nickdpz/Control-de-Inversor/README.md

# Control-de-Inversor
A partir de una fuente DC se obtiene una señal ac proporcional al voltaje DC. Se utiliza modulacion bipolar para obtener la señal a.c despues de pasar por un filtro rlc que filtre las frecuencias superiores a 60Hz. Se utiliza la topoligia de Mosfet de potencia en puente, los disparos de los mosfet se realizan con un circuito integrado que incorpora el efecto bootstrap.
