nickdpz/Control-de-Inversor/Esquematico.PDF

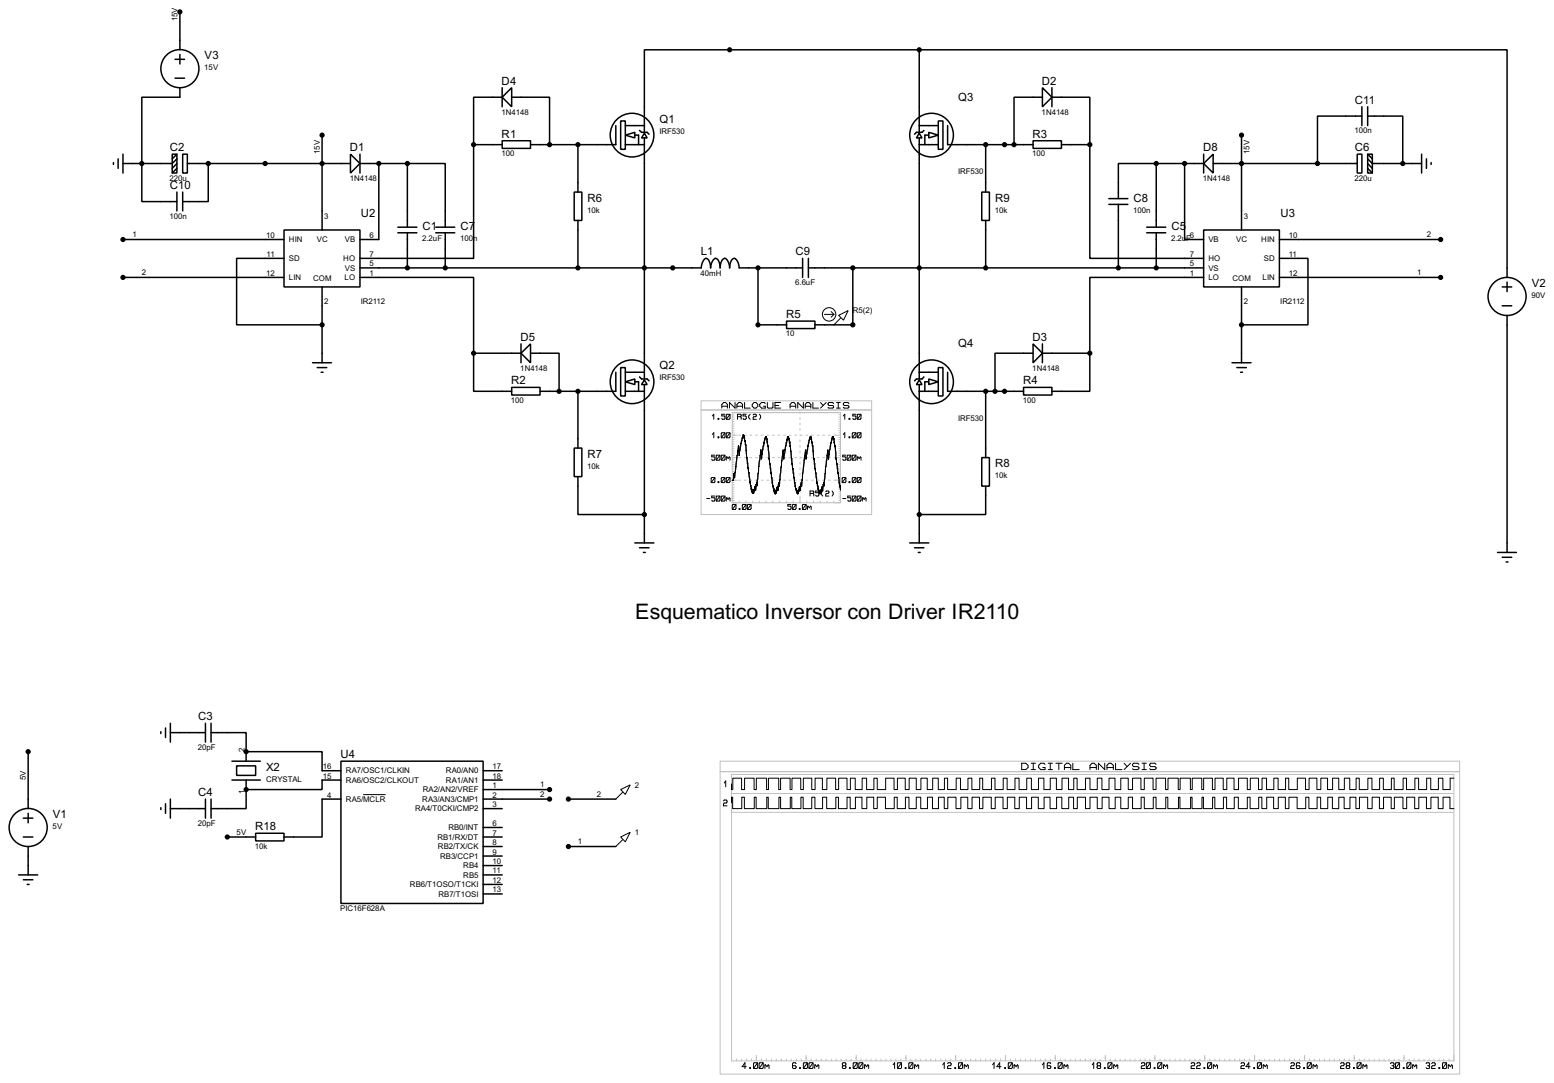
[picture p7: page 1]

Esquematico Inversor con Driver IR2110
