nickdpz/Control-de-Inversor/(list of files, drawings)

Other design files:
Inversor.pdsprj
