nickdpz/Control-de-Inversor/(commit log)

2018-01-06 Señal con nivel DC
    Se añade el esquematico, el informe, el codigo fuente para pic 16F628A y su simulacion correspondiente con apuntes obtenidos por experimentacion
    [Inversor.pdsprj]
2018-01-06 Se añade la carpeta del control
2018-01-06 Se añade el archivo en c
